sv1jsb/r2dino/img/r2dino_menu.jpg

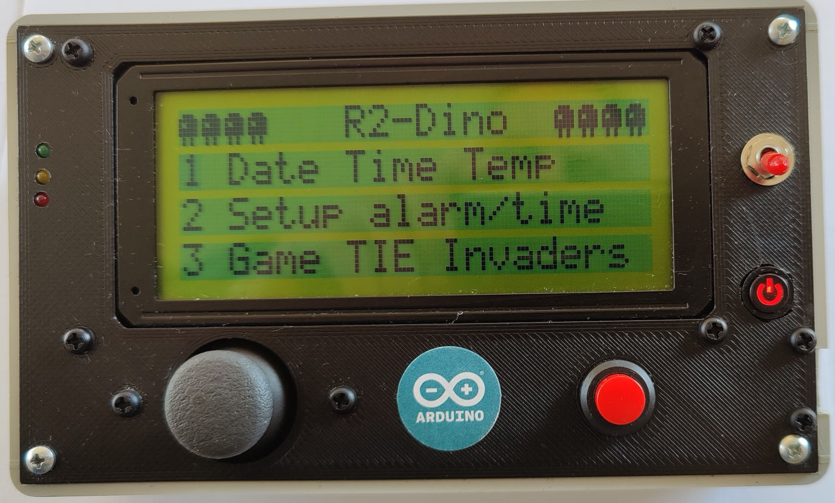
img/r2dino_menu.jpg
